akohlsmith/kiwi-basic/pcb/kiwi-basic-pcb.pdf

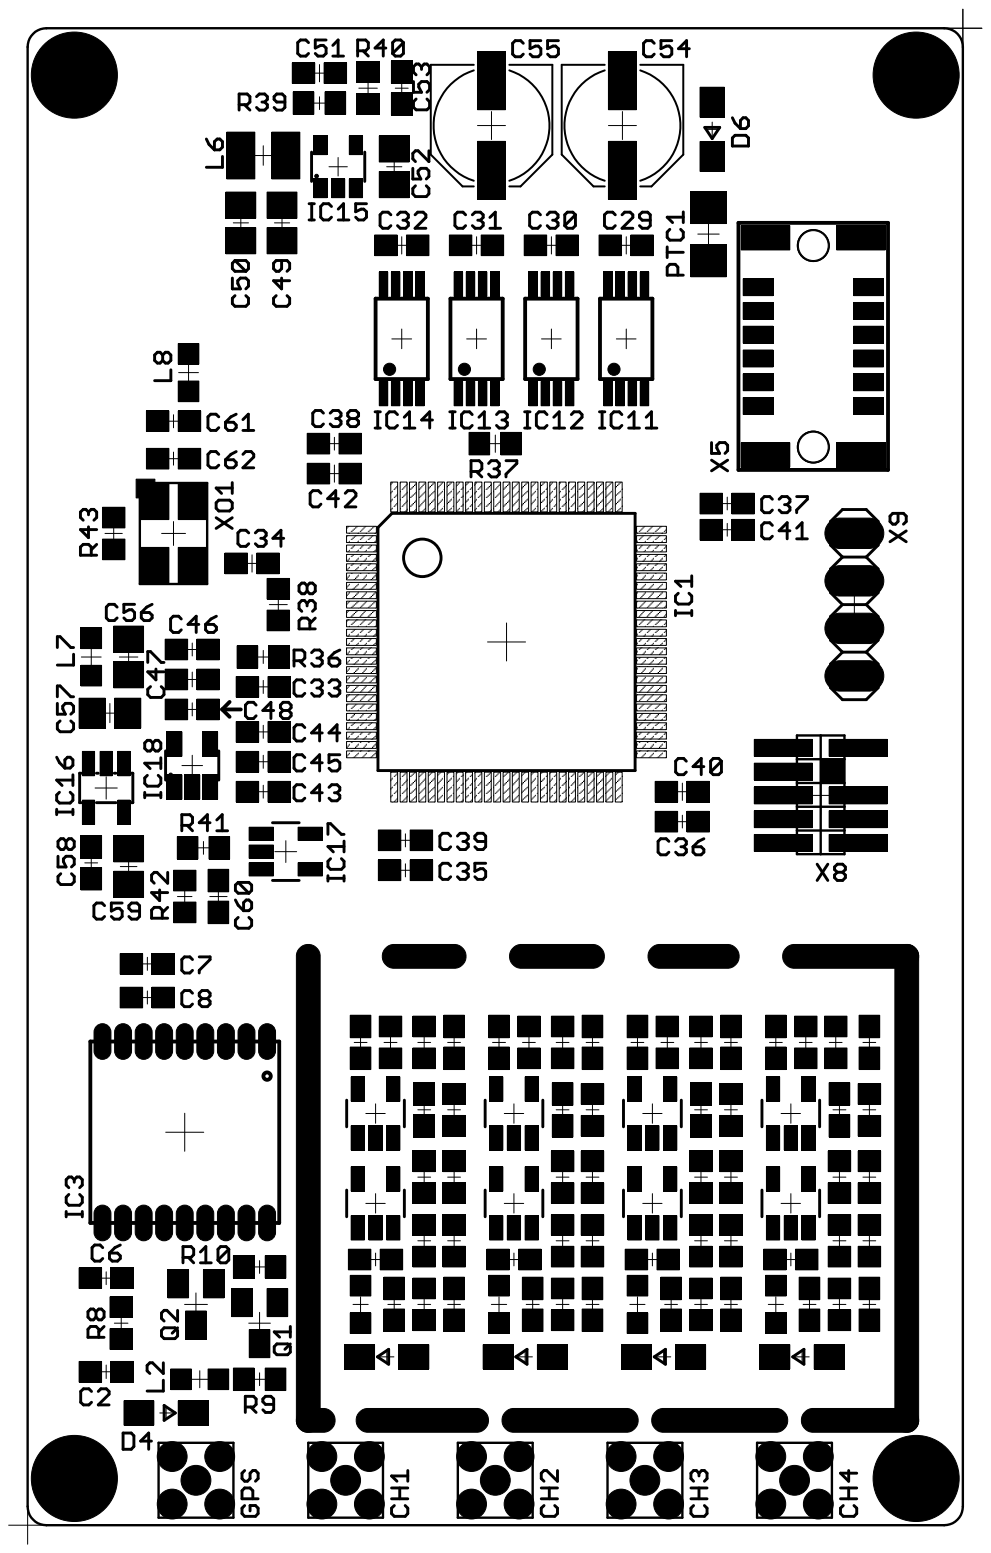
[picture p1: page 1]
