akohlsmith/kiwi-basic/pcb/kiwi-basic-sch.pdf

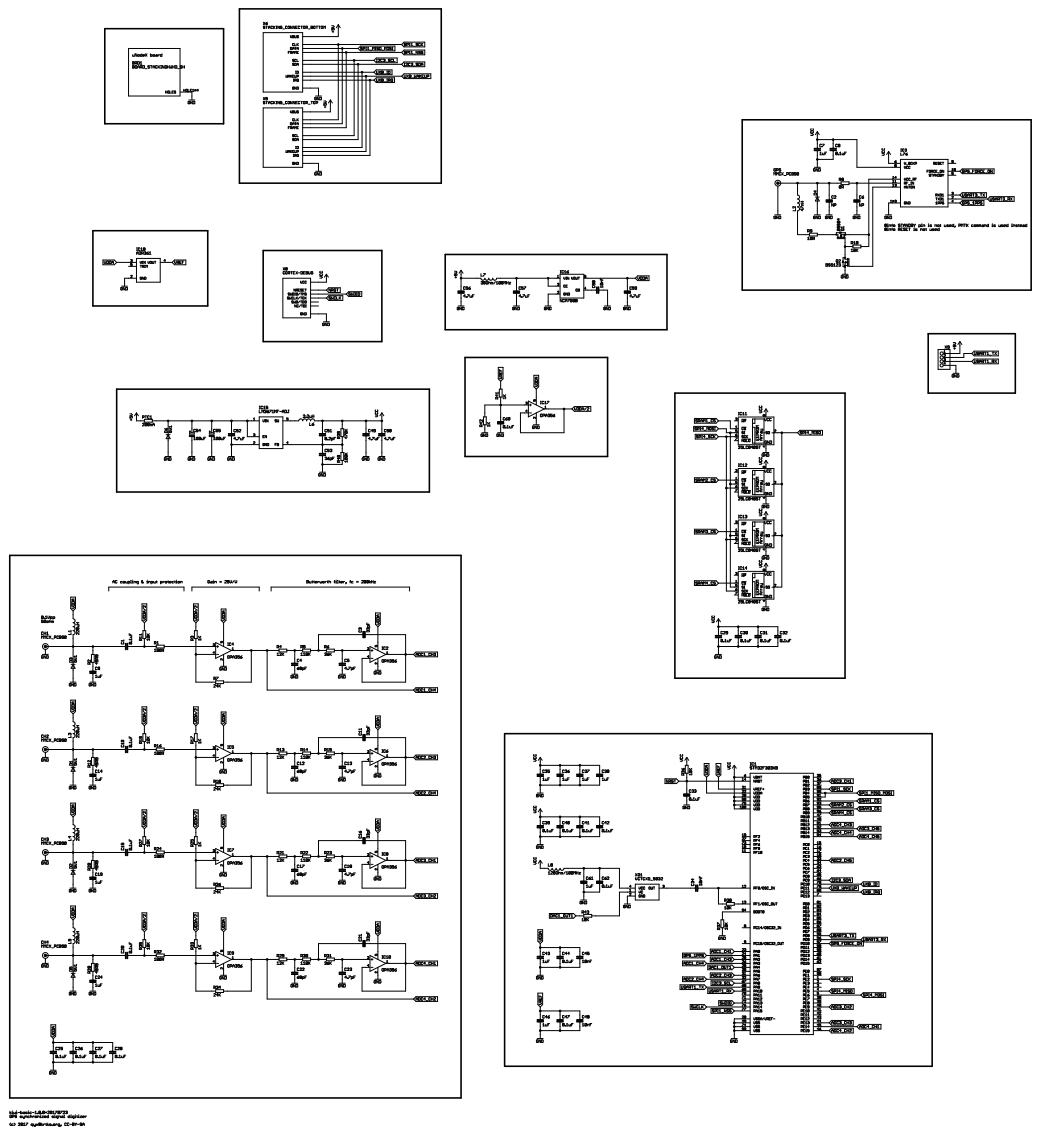
[picture p2: page 1]
