akohlsmith/kiwi-basic/pcb/kiwi-basic.brd

## EAGLE design pcb/kiwi-basic.brd (2017-09-06)

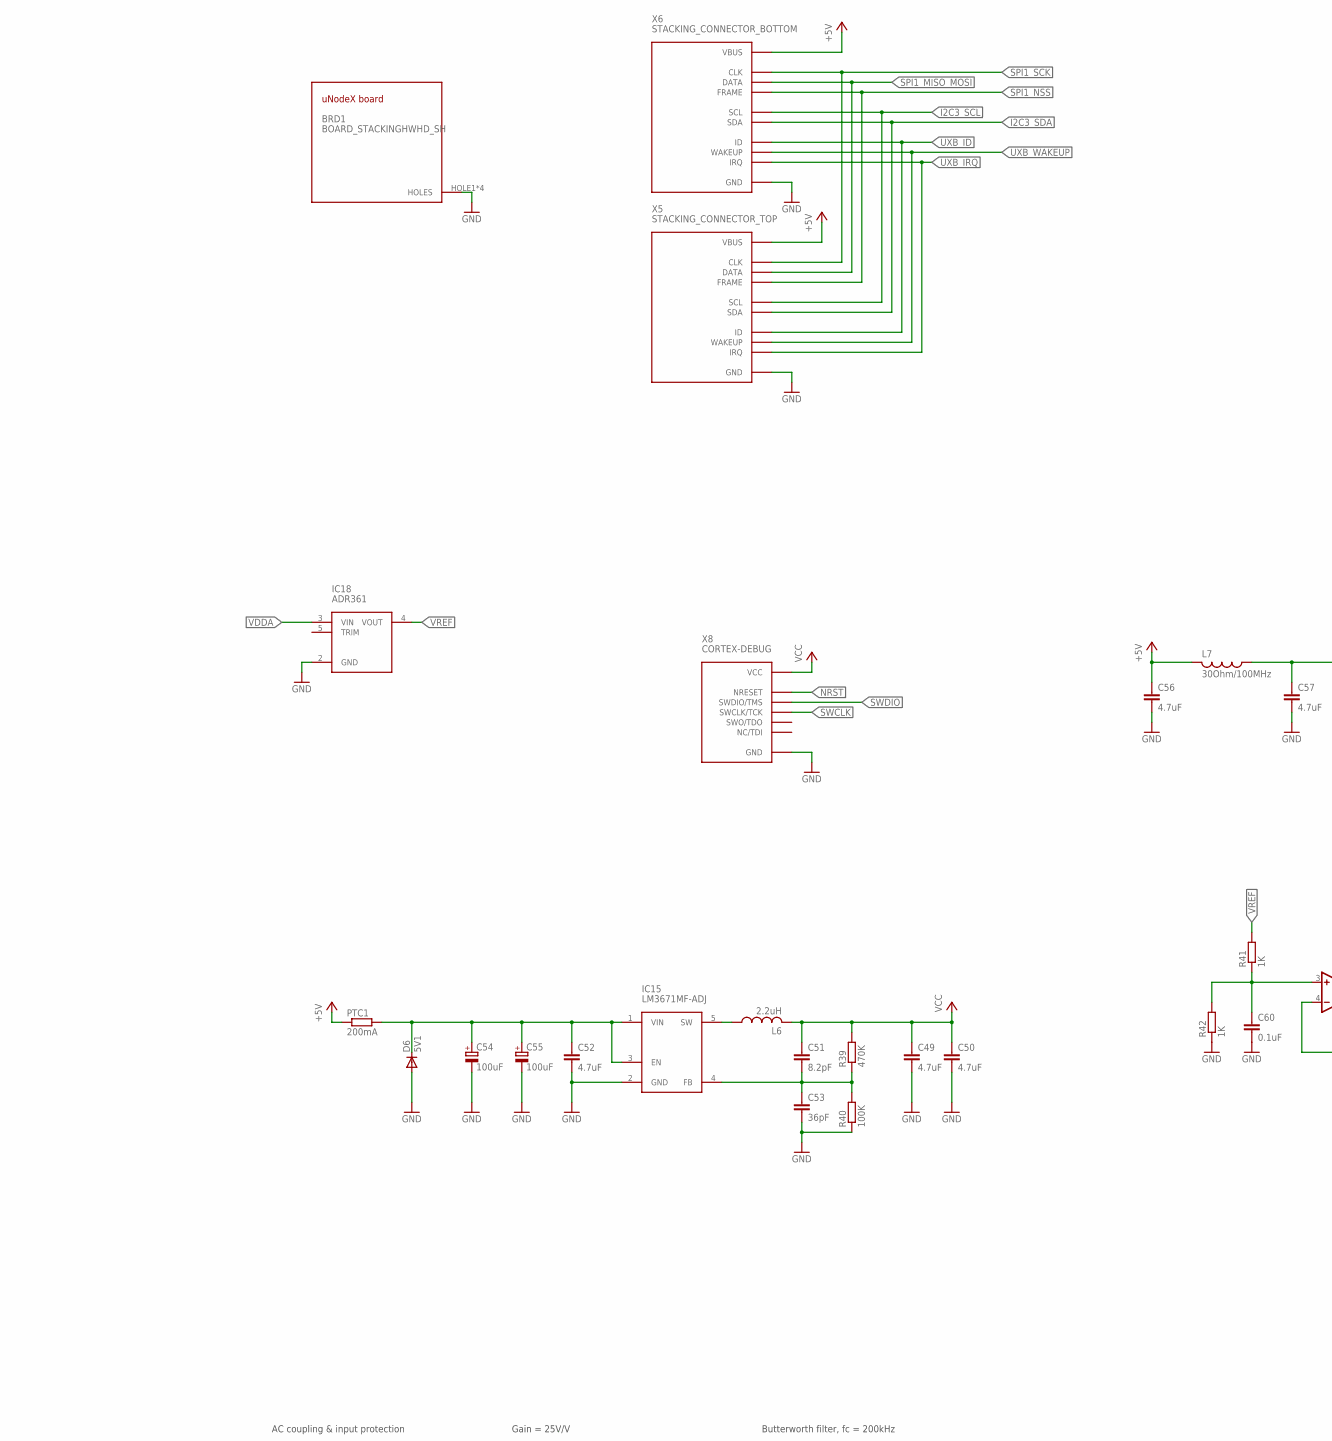
[picture p3: schematic kiwi-basic.sch, part in row 1, column 1]

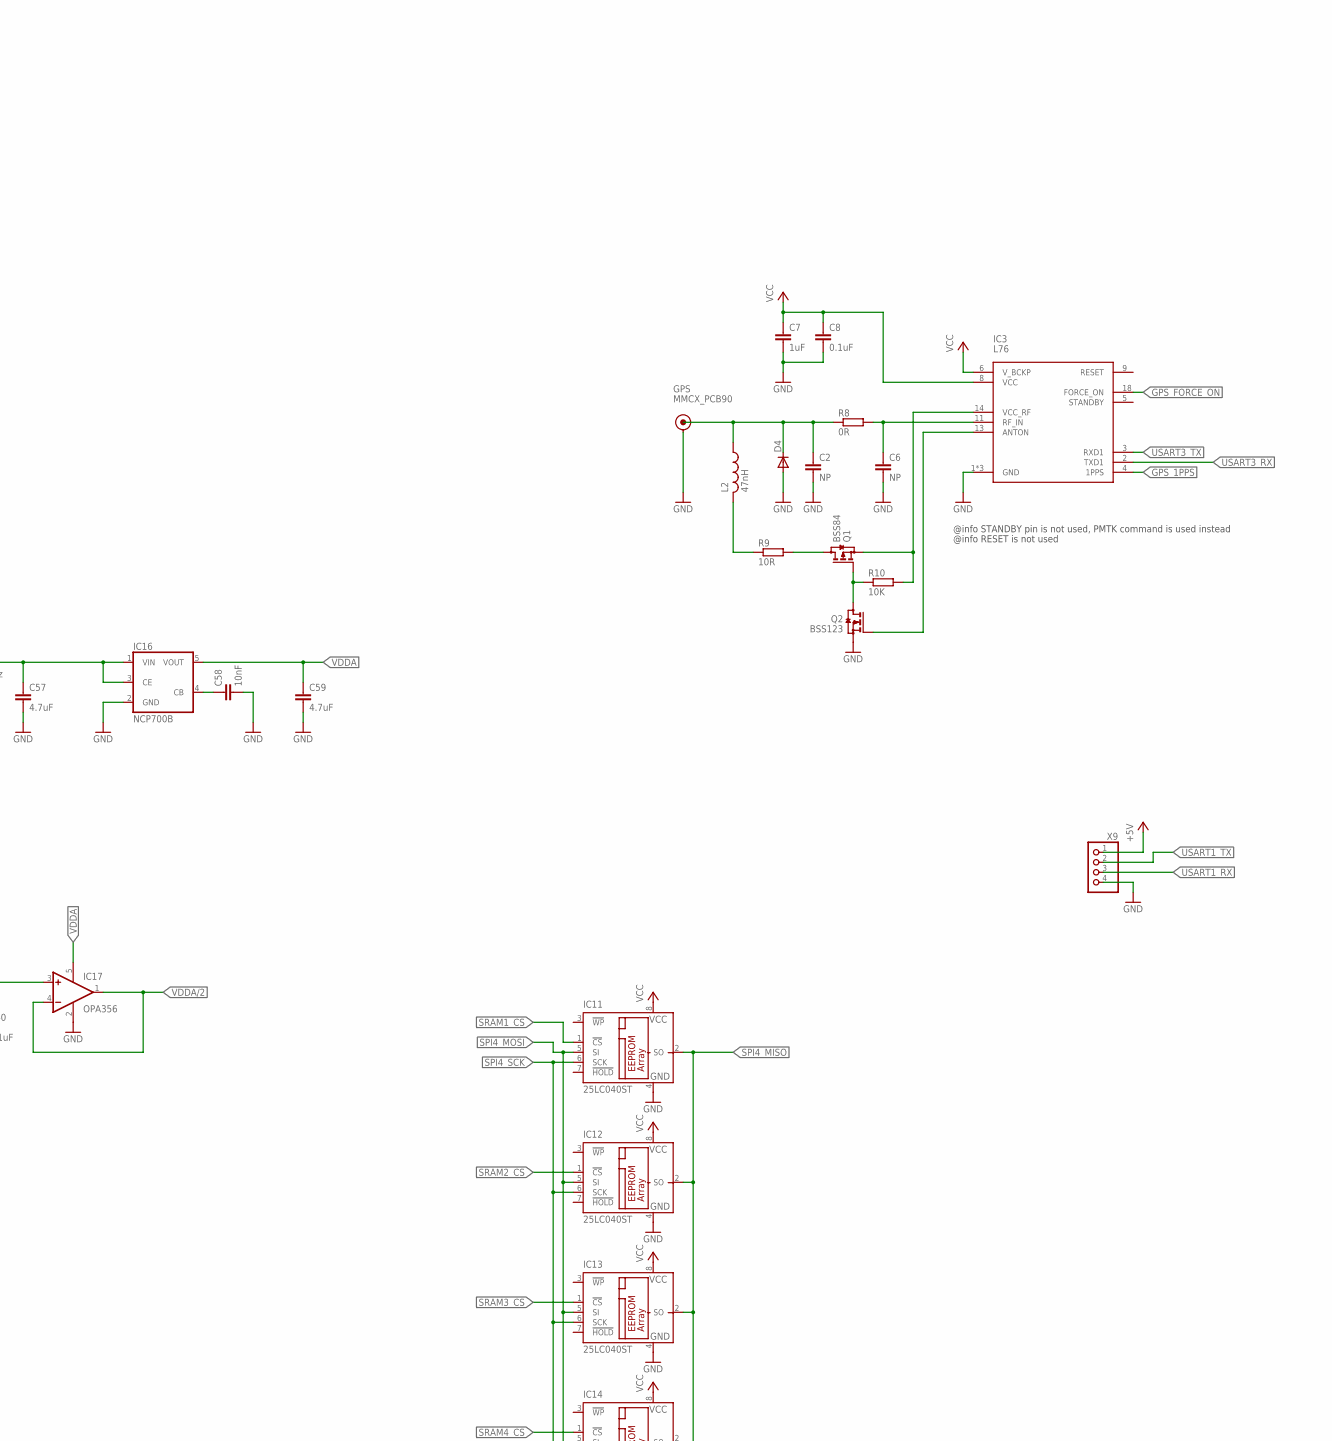
[picture p4: schematic kiwi-basic.sch, part in row 1, column 2]

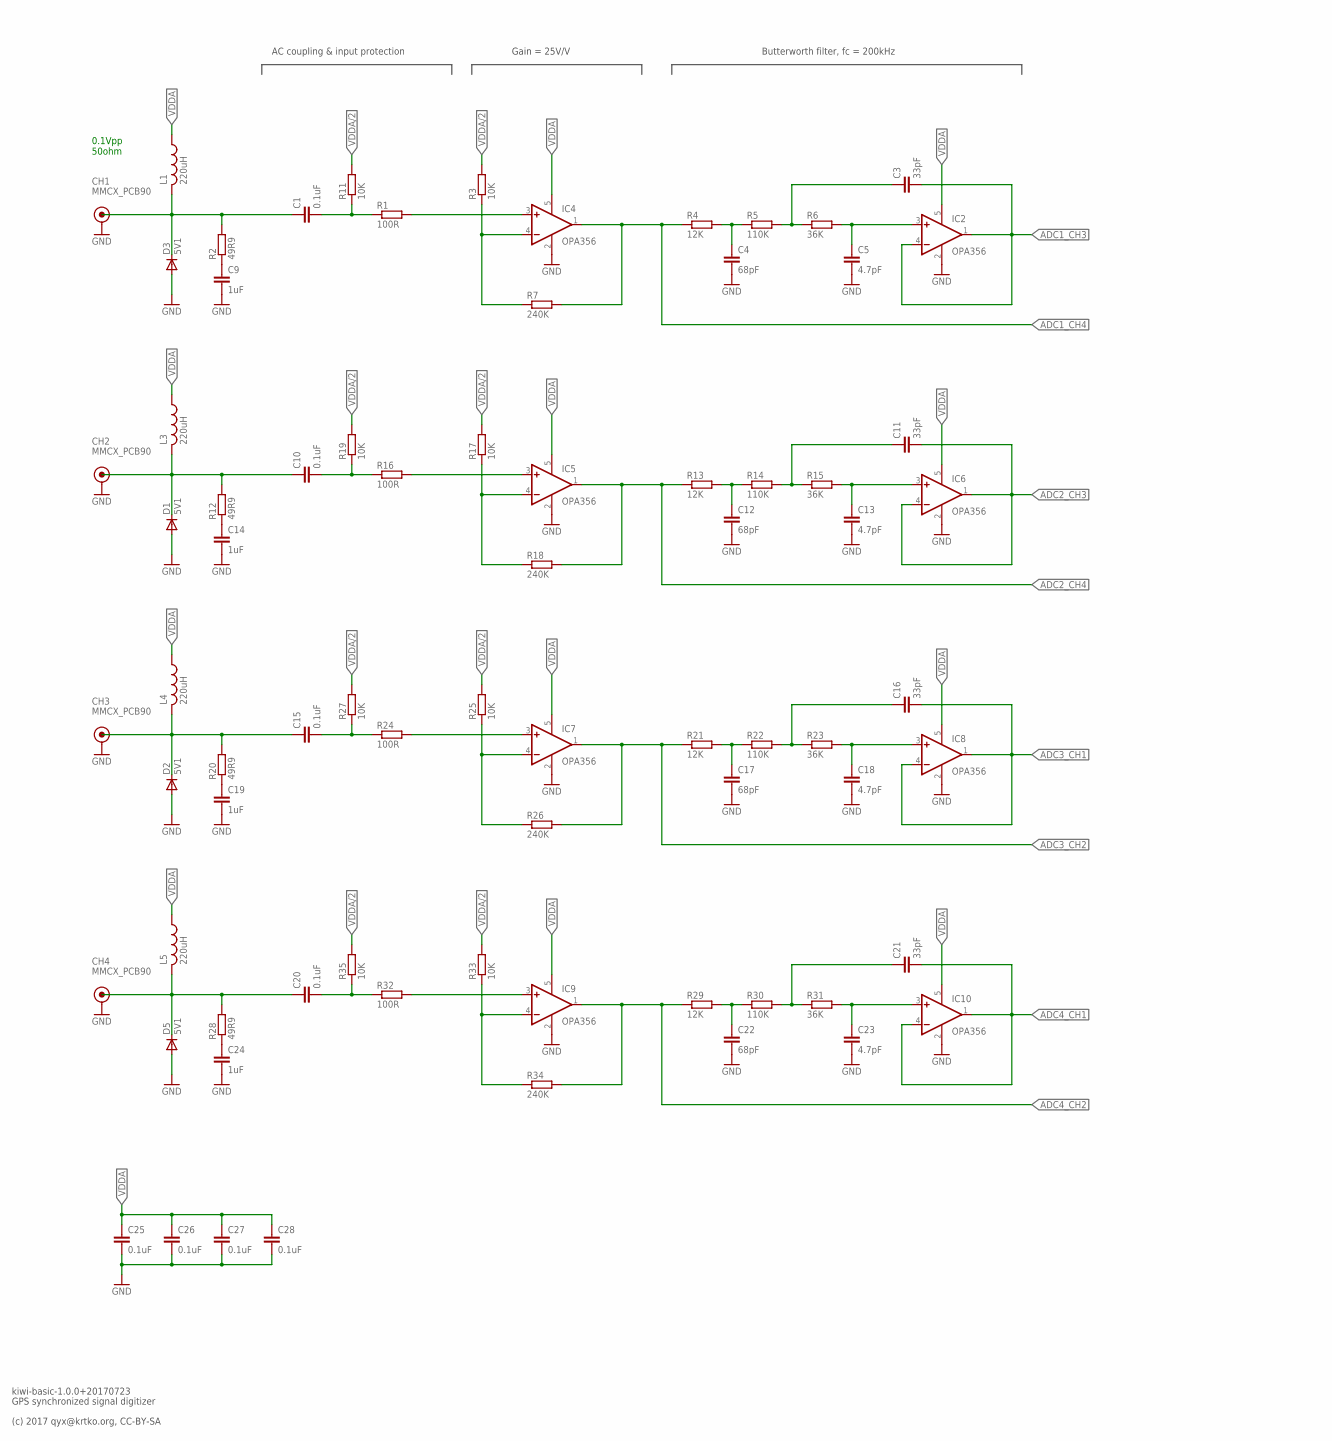
[picture p5: schematic kiwi-basic.sch, part in row 2, column 1]

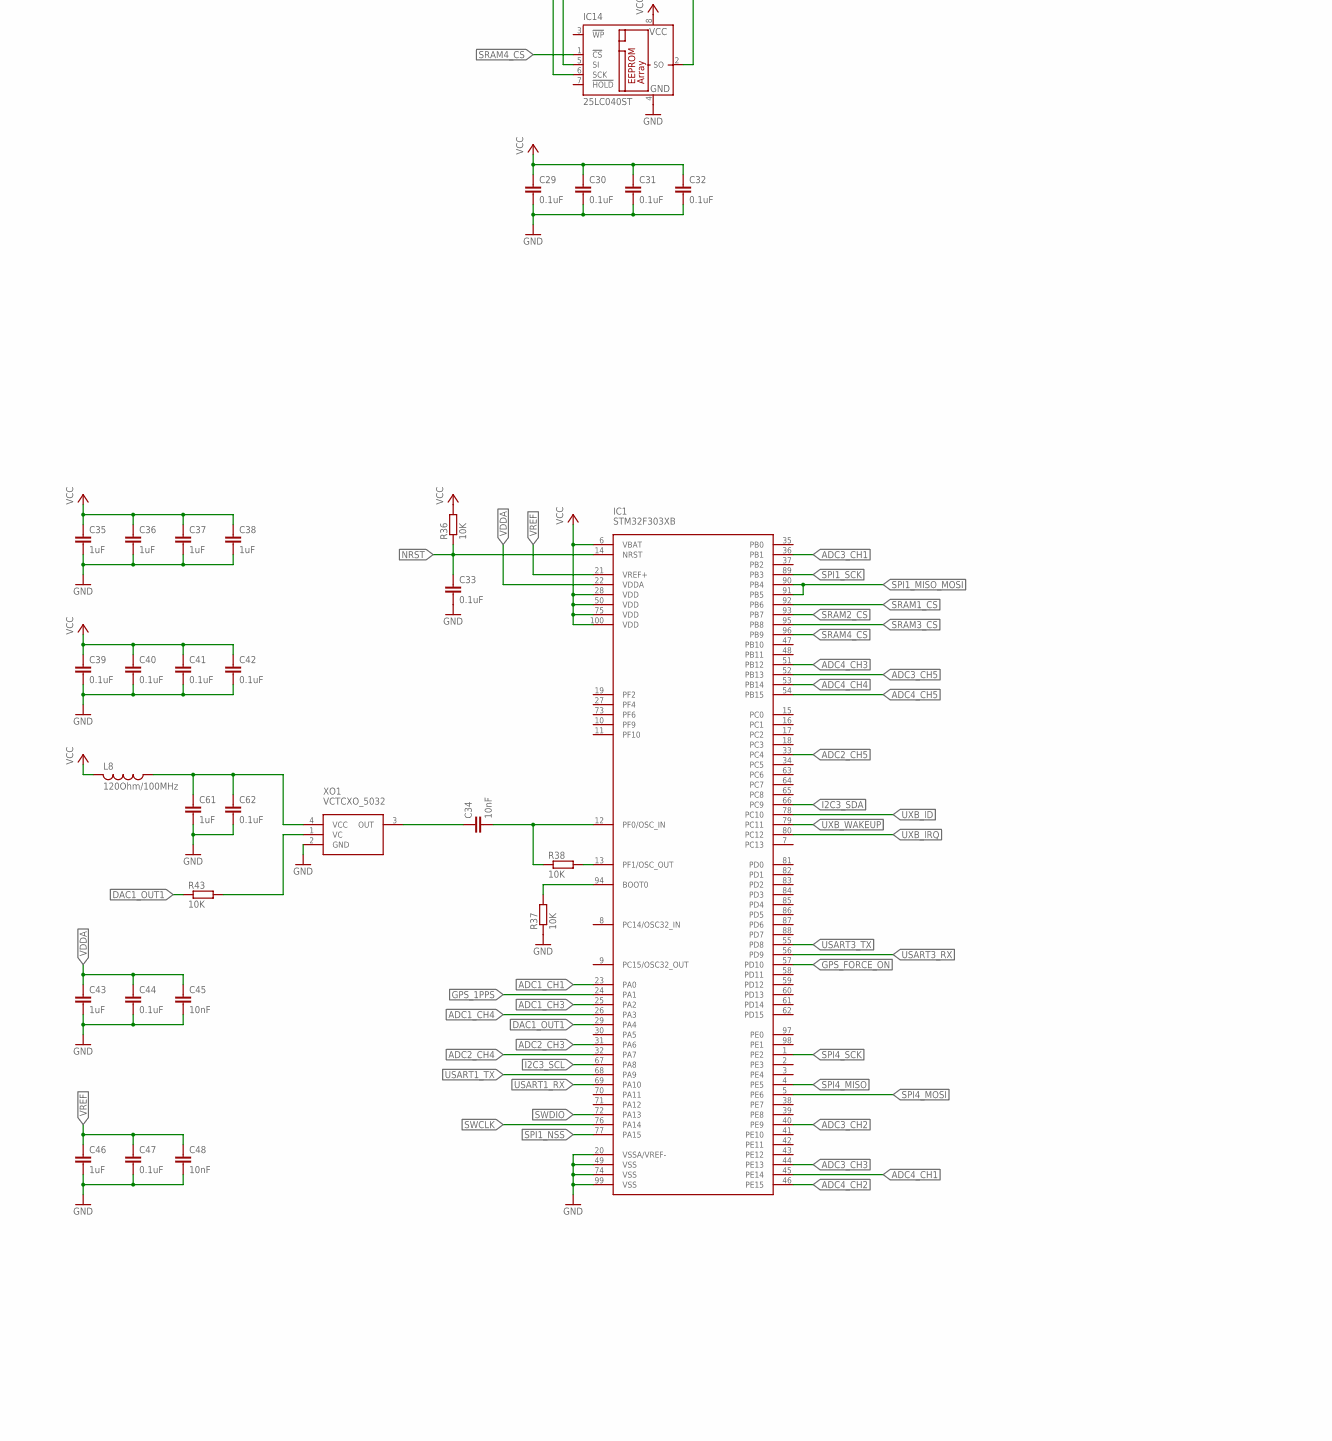
[picture p6: schematic kiwi-basic.sch, part in row 2, column 2]

Parts:
BRD1: BOARD_STACKINGHWHD_SH; HWHD_SHARP_CORNERS
C1, C8, C10, C15, C20, C25, C26, C27, C28, C29, C30, C31, C32, C33, C39, C40, C41, C42, C44, C47, C60, C62: 0.1uF; C0603
C2, C6: NP; C0603
C3, C11, C16, C21: 33pF; C0603
C4, C12, C17, C22: 68pF; C0603
C5, C13, C18, C23: 4.7pF; C0603
C7, C9, C14, C19, C24, C35, C36, C37, C38, C43, C46, C61: 1uF; C0603
C34, C45, C48, C58: 10nF; C0603
C49, C50, C52, C56, C57, C59: 4.7uF; C0805
C51: 8.2pF; C0603
C53: 36pF; C0603
C54, C55: 100uF; PANASONIC_D
CH1, CH2, CH3, CH4: MMCX_PCB90; MMCX_PCB_90
D1, D2, D3, D5, D6: 5V1; SOD323-W
D4: DIODE-SOD323-W; SOD323-W
GPS: MMCX_PCB90; MMCX_PCB_90
IC1: STM32F303XB; TQFP100
IC2, IC4, IC5, IC6, IC7, IC8, IC9, IC10, IC17: OPA356; SOT23-5
IC3: L76
IC11, IC12, IC13, IC14: 25LC040ST; TSSOP8
IC15: LM3671MF-ADJ; SOT23-5
IC16: NCP700B; SOT25
IC18: ADR361; SOT23-5
L1, L3, L4, L5: 220uH; L2012C
L2: 47nH; L2012C
L6: 2.2uH; L2825P
L7: 30Ohm/100MHz; L2012C
L8: 120Ohm/100MHz; L2012C
PTC1: 200mA; R1206
Q1: BSS84; SOT23
Q2: BSS123; SOT23
R1, R16, R24, R32: 100R; R0603
R2, R12, R20, R28: 49R9; R0603
R3, R10, R11, R17, R19, R25, R27, R33, R35, R36, R37, R38, R43: 10K; R0603
R4, R13, R21, R29: 12K; R0603
R5, R14, R22, R30: 110K; R0603
R6, R15, R23, R31: 36K; R0603
R7, R18, R26, R34: 240K; R0603
R8: 0R; R0603
R9: 10R; R0603
R39: 470K; R0603
R40: 100K; R0603
R41, R42: 1K; R0603
X5: STACKING_CONNECTOR_TOP; HAR-FLEX-TOP-12P
X6: STACKING_CONNECTOR_BOTTOM; HAR-FLEX-BOTTOM-12P
X8: CORTEX-DEBUG
X9: PINHD-1X4; 1X04
XO1: VCTCXO_5032; XTAL_5032

Connections:
+5V: C56.1, L7.2, PTC1.1, X5.VBUS, X6.VBUS, X9.1
ADC1_CH1: IC1.23 (PA0)
ADC1_CH3: C3.2, IC1.25 (PA2), IC2.1 (OUT), IC2.4 (-IN)
ADC1_CH4: IC1.26 (PA3), IC4.1 (OUT), R4.1, R7.2
ADC2_CH3: C11.2, IC1.31 (PA6), IC6.1 (OUT), IC6.4 (-IN)
ADC2_CH4: IC1.32 (PA7), IC5.1 (OUT), R13.1, R18.2
ADC2_CH5: IC1.33 (PC4)
ADC3_CH1: C16.2, IC1.36 (PB1), IC8.1 (OUT), IC8.4 (-IN)
ADC3_CH2: IC1.40 (PE9), IC7.1 (OUT), R21.1, R26.2
ADC3_CH3: IC1.44 (PE13)
ADC3_CH5: IC1.52 (PB13)
ADC4_CH1: C21.2, IC1.45 (PE14), IC10.1 (OUT), IC10.4 (-IN)
ADC4_CH2: IC1.46 (PE15), IC9.1 (OUT), R29.1, R34.2
ADC4_CH3: IC1.51 (PB12)
ADC4_CH4: IC1.53 (PB14)
ADC4_CH5: IC1.54 (PB15)
DAC1_OUT1: IC1.29 (PA4), R43.1
GND: BRD1.HOLE1, BRD1.HOLE2, BRD1.HOLE3, BRD1.HOLE4, C2.2, C4.2, C5.2, C6.2, C7.2, C8.2, C9.2, C12.2, C13.2, C14.2, C17.2, C18.2, C19.2, C22.2, C23.2, C24.2, C25.2, C26.2, C27.2, C28.2, C29.2, C30.2, C31.2, C32.2, C33.2, C35.2, C36.2, C37.2, C38.2, C39.2, C40.2, C41.2, C42.2, C43.2, C44.2, C45.2, C46.2, C47.2, C48.2, C49.2, C50.2, C52.2, C53.2, C54.-, C55.-, C56.2, C57.2, C58.2, C59.2, C60.2, C61.2, C62.2, CH1.S1 (SHIELD), CH1.S2 (SHIELD), CH1.S3 (SHIELD), CH1.S4 (SHIELD), CH2.S1 (SHIELD), CH2.S2 (SHIELD), CH2.S3 (SHIELD), CH2.S4 (SHIELD), CH3.S1 (SHIELD), CH3.S2 (SHIELD), CH3.S3 (SHIELD), CH3.S4 (SHIELD), CH4.S1 (SHIELD), CH4.S2 (SHIELD), CH4.S3 (SHIELD), CH4.S4 (SHIELD), D1.A, D2.A, D3.A, D4.A, D5.A, D6.A, GPS.S1 (SHIELD), GPS.S2 (SHIELD), GPS.S3 (SHIELD), GPS.S4 (SHIELD), IC1.20 (VSSA/VREF-), IC1.49 (VSS), IC1.74 (VSS), IC1.99 (VSS), IC2.2 (V-), IC3.1 (GND), IC3.10 (GND), IC3.12 (GND), IC4.2 (V-), IC5.2 (V-), IC6.2 (V-), IC7.2 (V-), IC8.2 (V-), IC9.2 (V-), IC10.2 (V-), IC11.4 (GND), IC12.4 (GND), IC13.4 (GND), IC14.4 (GND), IC15.2 (GND), IC16.2 (GND), IC17.2 (V-), IC18.2 (GND), Q2.2 (S), R37.1, R40.1, R42.1, X5.GND1 (GND), X5.GND2 (GND), X5.GND3 (GND), X5.H1 (GND), X5.H2 (GND), X5.H3 (GND), X5.H4 (GND), X6.GND1 (GND), X6.GND2 (GND), X6.GND3 (GND), X6.H1 (GND), X6.H2 (GND), X6.H3 (GND), X6.H4 (GND), X8.GND1 (GND), X8.GND2 (GND), X8.GND_DETECT (GND), X9.4, XO1.2 (GND)
GPS_1PPS: IC1.24 (PA1), IC3.4 (1PPS)
GPS_FORCE_ON: IC1.57 (PD10), IC3.18 (FORCE_ON)
I2C3_SCL: IC1.67 (PA8), X5.SCL, X6.SCL
I2C3_SDA: IC1.66 (PC9), X5.SDA, X6.SDA
unnamed: C9.1, R2.1
unnamed: IC4.3 (+IN), R1.2
unnamed: C1.1, CH1.C (CENTER), D3.C, L1.2, R2.2
unnamed: C1.2, R1.1, R11.1
unnamed: C4.1, R4.2, R5.1
unnamed: C3.1, R5.2, R6.1
unnamed: C5.1, IC2.3 (+IN), R6.2
unnamed: IC4.4 (-IN), R3.1, R7.1
unnamed: C10.1, CH2.C (CENTER), D1.C, L3.2, R12.2
unnamed: C2.1, D4.C, GPS.C (CENTER), L2.1, R8.1
unnamed: C6.1, IC3.11 (RF_IN), R8.2
unnamed: L2.2, R9.1
unnamed: IC3.14 (VCC_RF), Q1.2 (S), R10.2
unnamed: Q1.3 (D), R9.2
unnamed: Q1.1 (G), Q2.3 (D), R10.1
unnamed: IC3.13 (ANTON), Q2.1 (G)
unnamed: C12.1, R13.2, R14.1
unnamed: C11.1, R14.2, R15.1
unnamed: C13.1, IC6.3 (+IN), R15.2
unnamed: IC5.4 (-IN), R17.1, R18.1
unnamed: IC5.3 (+IN), R16.2
unnamed: C14.1, R12.1
unnamed: C10.2, R16.1, R19.1
unnamed: C15.1, CH3.C (CENTER), D2.C, L4.2, R20.2
unnamed: C17.1, R21.2, R22.1
unnamed: C16.1, R22.2, R23.1
unnamed: C18.1, IC8.3 (+IN), R23.2
unnamed: IC7.4 (-IN), R25.1, R26.1
unnamed: IC7.3 (+IN), R24.2
unnamed: C19.1, R20.1
unnamed: C15.2, R24.1, R27.1
unnamed: C20.1, CH4.C (CENTER), D5.C, L5.2, R28.2
unnamed: C22.1, R29.2, R30.1
unnamed: C21.1, R30.2, R31.1
unnamed: C23.1, IC10.3 (+IN), R31.2
unnamed: IC9.4 (-IN), R33.1, R34.1
unnamed: IC9.3 (+IN), R32.2
unnamed: C24.1, R28.1
unnamed: C20.2, R32.1, R35.1
unnamed: IC1.94 (BOOT0), R37.2
unnamed: IC1.13 (PF1/OSC_OUT), R38.2
unnamed: C51.2, C53.1, IC15.4 (FB), R39.1, R40.2
unnamed: IC15.5 (SW), L6.1
unnamed: C57.1, IC16.1 (VIN), IC16.3 (CE), L7.1
unnamed: C58.1, IC16.4 (CB)
unnamed: C60.1, IC17.3 (+IN), R41.1, R42.2
unnamed: C34.1, XO1.3 (OUT)
unnamed: C61.1, C62.1, L8.1, XO1.4 (VCC)
unnamed: R43.2, XO1.1 (VC)
NRST: C33.1, IC1.14 (NRST), R36.1, X8.NRESET
SPI1_MISO_MOSI: IC1.90 (PB4), IC1.91 (PB5), X5.DATA, X6.DATA
SPI1_NSS: IC1.77 (PA15), X5.FRAME, X6.FRAME
SPI1_SCK: IC1.89 (PB3), X5.CLK, X6.CLK
SPI4_MISO: IC1.4 (PE5), IC11.2 (SO), IC12.2 (SO), IC13.2 (SO), IC14.2 (SO)
SPI4_MOSI: IC1.5 (PE6), IC11.5 (SI), IC12.5 (SI), IC13.5 (SI), IC14.5 (SI)
SPI4_SCK: IC1.1 (PE2), IC11.6 (SCK), IC12.6 (SCK), IC13.6 (SCK), IC14.6 (SCK)
SRAM1_CS: IC1.92 (PB6), IC11.1 (!CS)
SRAM2_CS: IC1.93 (PB7), IC12.1 (!CS)
SRAM3_CS: IC1.95 (PB8), IC13.1 (!CS)
SRAM4_CS: IC1.96 (PB9), IC14.1 (!CS)
SWCLK: IC1.76 (PA14), X8.SWCLK/TCK
SWDIO: IC1.72 (PA13), X8.SWDIO/TMS
TCXO_CLK: C34.2, IC1.12 (PF0/OSC_IN), R38.1
USART1_RX: IC1.69 (PA10), X9.3
USART1_TX: IC1.68 (PA9), X9.2
USART3_RX: IC1.56 (PD9), IC3.2 (TXD1)
USART3_TX: IC1.55 (PD8), IC3.3 (RXD1)
UXB_ID: IC1.78 (PC10), X5.ID, X6.ID
UXB_IRQ: IC1.80 (PC12), X5.IRQ, X6.IRQ
UXB_WAKEUP: IC1.79 (PC11), X5.WAKEUP, X6.WAKEUP
VBUS: C52.1, C54.+, C55.+, D6.C, IC15.1 (VIN), IC15.3 (EN), PTC1.2
VCC: C7.1, C8.1, C29.1, C30.1, C31.1, C32.1, C35.1, C36.1, C37.1, C38.1, C39.1, C40.1, C41.1, C42.1, C49.1, C50.1, C51.1, IC1.6 (VBAT), IC1.28 (VDD), IC1.50 (VDD), IC1.75 (VDD), IC1.100 (VDD), IC3.6 (V_BCKP), IC3.8 (VCC), IC11.8 (VCC), IC12.8 (VCC), IC13.8 (VCC), IC14.8 (VCC), L6.2, L8.2, R36.2, R39.2, X8.VCC
VDDA: C25.1, C26.1, C27.1, C28.1, C43.1, C44.1, C45.1, C59.1, IC1.22 (VDDA), IC2.5 (V+), IC4.5 (V+), IC5.5 (V+), IC6.5 (V+), IC7.5 (V+), IC8.5 (V+), IC9.5 (V+), IC10.5 (V+), IC16.5 (VOUT), IC17.5 (V+), IC18.3 (VIN), L1.1, L3.1, L4.1, L5.1
VDDA/2: IC17.1 (OUT), IC17.4 (-IN), R3.2, R11.2, R17.2, R19.2, R25.2, R27.2, R33.2, R35.2
VREF: C46.1, C47.1, C48.1, IC1.21 (VREF+), IC18.4 (VOUT), R41.2

Notes on the sheet:
Gain = 25V/V
Butterworth filter, fc = 200kHz
AC coupling & input protection
@info STANDBY pin is not used, PMTK command is used instead
@info RESET is not used
0.1Vpp 50ohm
(c) 2017 qyx@krtko.org, CC-BY-SA
kiwi-basic-1.0.0+20170723
GPS synchronized signal digitizer

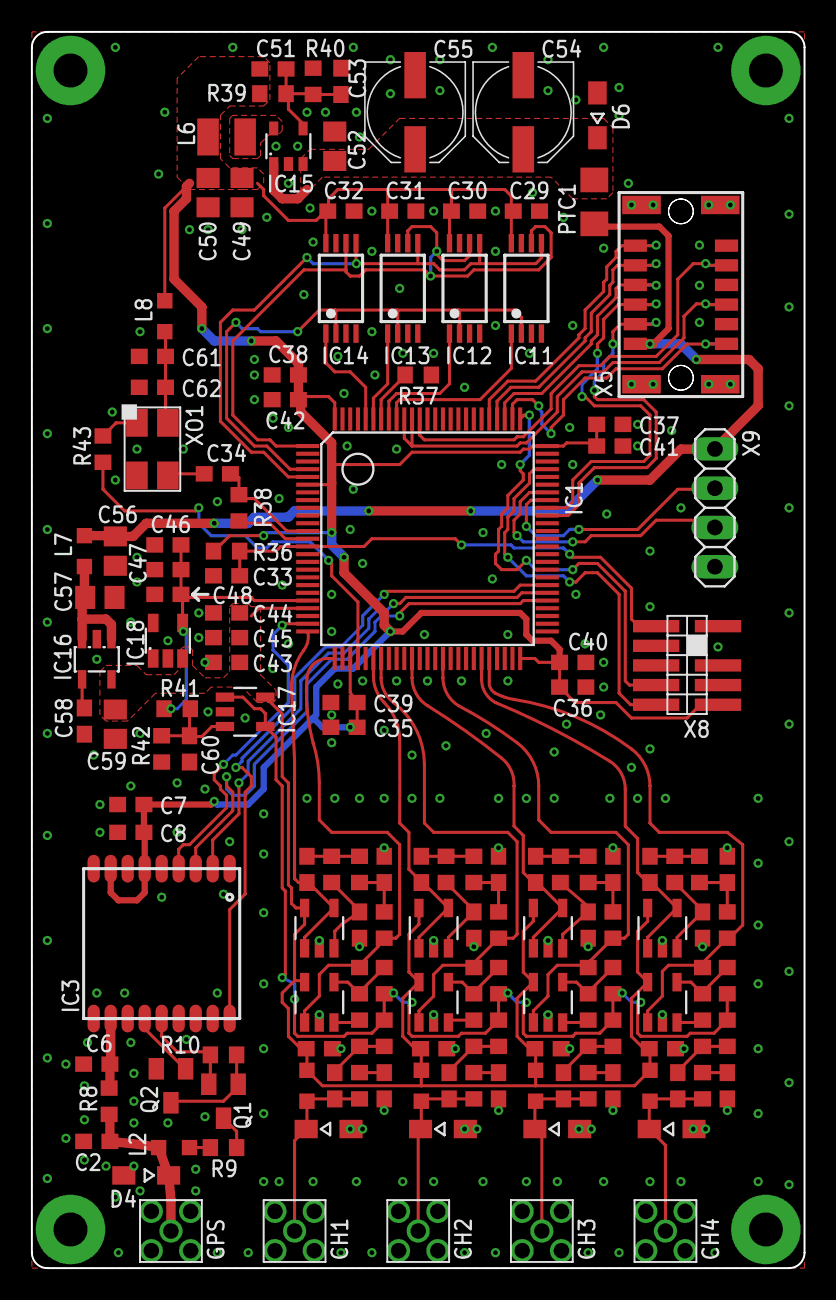
[picture p7: board kiwi-basic.brd from above]

Board: 2 copper layers, 50.0 x 80.0 mm, 151 parts (0 on the bottom side), 90 nets.
