akohlsmith/kiwi-basic/fw/uxb_slave.c

/*
 * UXB Bus slave communication handling
 *
 * Copyright (C) 2017, Marek Koza, qyx@krtko.org
 *
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
 * You should have received a copy of the GNU General Public License
 * along with this program.  If not, see <http://www.gnu.org/licenses/>.
 */

#include <stdint.h>
#include <stdbool.h>

#include <libopencm3/cm3/nvic.h>
#include <libopencm3/stm32/rcc.h>
#include <libopencm3/stm32/syscfg.h>
#include <libopencm3/stm32/gpio.h>
#include <libopencm3/stm32/timer.h>
#include <libopencm3/stm32/spi.h>
#include <libopencm3/stm32/exti.h>

#include "board.h"
#include "libuxb.h"
#include "uxb_slave.h"
#include "uxb_waveform.h"


#define DELAY_TIMER TIM7
#define DELAY_TIMER_RCC RCC_TIM7

const struct uxb_master_locm3_config uxb_slave_config = {
	.spi_port = SPI1,
	.spi_af = GPIO_AF5,
	.sck_port = GPIOB, .sck_pin = GPIO3,
	.miso_port = GPIOB, .miso_pin = GPIO4,
	.mosi_port = GPIOB, .mosi_pin = GPIO5,
	.frame_port = GPIOA, .frame_pin = GPIO15,
	.id_port = GPIOC, .id_pin = GPIO10,
	.delay_timer = DELAY_TIMER,
	.delay_timer_freq_mhz = 1,
	.control_prescaler = SPI_CR1_BR_FPCLK_DIV_16,
	.data_prescaler = SPI_CR1_BR_FPCLK_DIV_16,
};


/* An UXB bus singleton. */
LibUxbBus uxb_bus;
LibUxbDevice uxb_device;

/* Minimum buffer size for a descriptor line is 64 bytes (including the trailing \0). */
LibUxbSlot descriptor_slot;
uint8_t descriptor_slot_buffer[64];

LibUxbSlot waveform_slot;
uint8_t waveform_slot_buffer[128];
UxbWaveform uxb_waveform;

const uint8_t master_address[] = {0};

/* Default interface address. It will be copied from the MCU unique identity
 * during initialization. */
uint8_t device_address[] = {0, 0, 0, 0, 0, 0, 0, 7};

#define UXB_DESCRIPTOR_SIZE 4
const char *uxb_descriptor[] = {
	"device=kiwi-basic",
	"hw-version=" HARDWARE_VERSION,
	"fw-version=" FIRMWARE_VERSION,
	"slot=1,waveform-source-1.0.0",
};


static uxb_master_locm3_ret_t uxb_read_descriptor(void *context, uint8_t *buf, size_t len) {
	(void)context;

	uint8_t zero = 0;

	if (len != 1) {
		return UXB_MASTER_LOCM3_RET_FAILED;
	}
	if (buf[0] == 0) {
		/* Send the 0 back. */
		libuxb_slot_send_data(&descriptor_slot, &zero, 1, true);
	} else {
		uint8_t descriptor_index = buf[0] - 1;
		if (descriptor_index >= UXB_DESCRIPTOR_SIZE) {
			libuxb_slot_send_data(&descriptor_slot, &zero, 1, true);
		} else {
			libuxb_slot_send_data(&descriptor_slot, (uint8_t *)uxb_descriptor[descriptor_index], strlen(uxb_descriptor[descriptor_index]) + 1, true);
		}
	}

	return UXB_MASTER_LOCM3_RET_OK;
}


static uxb_master_locm3_ret_t waveform_slot_received(void *context, uint8_t *buf, size_t len) {
	(void)context;

	uxb_waveform_message_received(&uxb_waveform, buf, len);

	return UXB_MASTER_LOCM3_RET_OK;
}


uxb_slave_ret_t uxb_slave_init(void) {
	/* Initialize the UXB bus. */
	rcc_periph_clock_enable(RCC_SPI1);
	rcc_periph_clock_enable(DELAY_TIMER_RCC);

	/* Setup a timer for precise UXB protocol delays. */
	timer_reset(DELAY_TIMER);
	timer_set_mode(DELAY_TIMER, TIM_CR1_CKD_CK_INT, TIM_CR1_CMS_EDGE, TIM_CR1_DIR_UP);
	timer_continuous_mode(DELAY_TIMER);
	timer_direction_up(DELAY_TIMER);
	timer_disable_preload(DELAY_TIMER);
	timer_enable_update_event(DELAY_TIMER);
	timer_set_prescaler(DELAY_TIMER, (rcc_ahb_frequency / 1000000) - 1);
	timer_set_period(DELAY_TIMER, 65535);
	timer_enable_counter(DELAY_TIMER);

	libuxb_bus_init(&uxb_bus, &uxb_slave_config);

	libuxb_device_init(&uxb_device);
	libuxb_device_set_address(&uxb_device, device_address, master_address);
	libuxb_bus_add_device(&uxb_bus, &uxb_device);

	libuxb_slot_init(&descriptor_slot);
	libuxb_slot_set_slot_number(&descriptor_slot, 0);
	libuxb_slot_set_slot_buffer(&descriptor_slot, descriptor_slot_buffer, sizeof(descriptor_slot_buffer));
	libuxb_slot_set_data_received(&descriptor_slot, uxb_read_descriptor, NULL);
	libuxb_device_add_slot(&uxb_device, &descriptor_slot);

	libuxb_slot_init(&waveform_slot);
	libuxb_slot_set_slot_number(&waveform_slot, 1);
	libuxb_slot_set_slot_buffer(&waveform_slot, waveform_slot_buffer, sizeof(waveform_slot_buffer));
	libuxb_slot_set_data_received(&waveform_slot, waveform_slot_received, NULL);
	uxb_waveform_init(&uxb_waveform, &waveform_slot, &sampler);
	libuxb_device_add_slot(&uxb_device, &waveform_slot);

	/* Setup uxb exti interrupts. */
	nvic_enable_irq(NVIC_EXTI15_10_IRQ);
	nvic_set_priority(NVIC_EXTI15_10_IRQ, 1 * 16);
	rcc_periph_clock_enable(RCC_SYSCFG);
	exti_select_source(EXTI15, GPIOA);
	exti_set_trigger(EXTI15, EXTI_TRIGGER_FALLING);
	exti_enable_request(EXTI15);

	return UXB_SLAVE_OK;
}


void exti15_10_isr(void) {
	exti_reset_request(EXTI15);
	exti_disable_request(EXTI15);
	libuxb_bus_frame_irq(&uxb_bus);
	exti_enable_request(EXTI15);
}
