akohlsmith/kiwi-basic/(commit log)

2017-09-06 Add schematic and layout of the PCB
    [kiwi-basic-bom.csv, kiwi-basic.brd, kiwi-basic.sch]
2017-10-31 Add Gerber outputs (seeedstudio names)
    [kiwi-basic.GBL, kiwi-basic.GBO, kiwi-basic.GBP, kiwi-basic.GBS, kiwi-basic.GTL, kiwi-basic.GTO, kiwi-basic.GTP, kiwi-basic.GTS]
2018-02-08 Move sampler code to a dedicated file
2018-02-13 UXB bus communication support
    Portions of the code were refactored. Sampler code was commeted
    more verbosely.
    Basic UXB implementation was done (libuxb, uxb_slave added) together
    with a waveform source definition (.proto).It is meant to be used
    for testing only.
